arkorobotics/CUBEX_V1/Code/Adafruit_VC0706/README.txt

  This is a library for the Adafruit TTL JPEG Camera (VC0706 chipset)

  Pick one up today in the adafruit shop!
  ------> http://www.adafruit.com/products/397

  These displays use Serial to communicate, 2 pins are required to interface

  Adafruit invests time and resources providing this open source code, 
  please support Adafruit and open-source hardware by purchasing 
  products from Adafruit!

  Written by Limor Fried/Ladyada for Adafruit Industries.  
  BSD license, all text above must be included in any redistribution

To download. click the DOWNLOADS button in the top right corner, rename the uncompressed folder Adafruit_VC0706. Check that the Adafruit_VC0706 folder contains Adafruit_VC0706.cpp and Adafruit_VC0706.h

Place the Adafruit_VC0706 library folder your <arduinosketchfolder>/libraries/ folder. You may need to create the libraries subfolder if its your first library. Restart the IDE.
