arkorobotics/CUBEX_V1/Board/BOM.xlsx

MOTHERBOARD
Part | Value | Device | Package | Description | LINK
C1 | 9pF | CAP0805 | 0805 | Capacitor | http://www.digikey.com/product-detail/en/CL21C090DBANNNC/1276-2559-1-ND/3890645
C2 | 9pF | CAP0805 | 0805 | Capacitor | http://www.digikey.com/product-detail/en/CL21C090DBANNNC/1276-2559-1-ND/3890645
C3 | 0.1uF | CAP0805 | 0805 | Capacitor | http://www.digikey.com/product-detail/en/C0805C104K5RACTU/399-1170-1-ND/411445
C4 | 0.01uF | CAP0805 | 0805 | Capacitor | http://www.digikey.com/product-detail/en/C0805C103K5RACTU/399-1158-1-ND/411433
C5 | 10uF | CAP_POL1206 | EIA3216 | Capacitor Polarized | http://www.digikey.com/product-detail/en/CL31A106KAHNNNE/1276-1075-1-ND/3889161
C6 | 1uF | CAP_POL1206 | EIA3216 | Capacitor Polarized | http://www.digikey.com/product-detail/en/C3216X7R1E105K085AA/445-1592-1-ND/603227
C7 | 0.1uF | SPARKFUN_CAP0805 | SPARKFUN_0805 | Capacitor | http://www.digikey.com/product-detail/en/C0805C104K5RACTU/399-1170-1-ND/411445
J1 | AVR ICSP | SPARKFUN_AVR_SPI_PRG_6NS | SPARKFUN_2X3-NS | AVR ISP 6 Pin | http://www.digikey.com/product-detail/en/961206-6404-AR/3M9459-ND/2071500
JP1 | M102MMSMD | M102MMSMD | 1X10-2MM-SMD | Header 10 | http://www.digikey.com/product-detail/en/0/3M9344DKR-ND
JP2 | M102MMSMD | M102MMSMD | 1X10-2MM-SMD | Header 10 | http://www.digikey.com/product-detail/en/0/3M9388DKR-ND
JP3 | M102MMSMD | M102MMSMD | 1X10-2MM-SMD | Header 10 | http://www.digikey.com/product-detail/en/0/3M9344DKR-ND
JP4 | M102MMSMD | M102MMSMD | 1X10-2MM-SMD | Header 10 | http://www.digikey.com/product-detail/en/0/3M9388DKR-ND
Q1 | SPARKFUN_MOSFET-PCHANNELSMD | SPARKFUN_MOSFET-PCHANNELSMD | SPARKFUN_SOT23-3 |  | http://www.digikey.com/product-detail/en/BSS84/BSS84CT-ND/244297
R1 | 10k | RESISTOR0805-RES | 0805 | Resistor | http://www.digikey.com/product-detail/en/RC0805JR-0710KL/311-10KARCT-ND/731188
R4 | 100R | SPARKFUN_RESISTOR0805-RES | 0805 | Resistor | http://www.digikey.com/product-detail/en/RC0805FR-07100RL/311-100CRCT-ND/730490
R5 | 10k | SPARKFUN_RESISTOR0805-RES | 0805 | Resistor | http://www.digikey.com/product-detail/en/RC0805JR-0710KL/311-10KARCT-ND/731188
U$2 | AVA_EDGE_ICSP | AVA_EDGE_ICSP | AVA_EDGE_MOUNTED_ICSP |  | http://www.digikey.com/product-detail/en/961206-6404-AR/3M9459-ND/2071500
U$3 | AVA_JTI_ANTENNA-1575AT43A40 | AVA_JTI_ANTENNA-1575AT43A40 | AVA_JTI_ANTENNA-1575AT43A40 |  | http://ava.upuaut.net/store/index.php?route=product/product&path=59_65&product_id=55
U$4 | AVA_UBLOX_MAX-6 | AVA_UBLOX_MAX-6 | AVA_UBLOX_MAX-6 | UBLOX MAX-6 | http://ava.upuaut.net/store/index.php?route=product/product&path=59_64&product_id=81
U$5 | AVA_EPSON_FA-20H_CRYSTAL | AVA_EPSON_FA-20H_CRYSTAL | AVA_EPSON-FA-20H-CRYSTAL |  | http://www.digikey.com/product-detail/en/CX3225SB16000E0FPZ25/478-4815-1-ND/1833878
U1 | AVA_ATMEGA328P-MU | AVA_ATMEGA328P-MU | AVA_QFN50P500X500X100-33N | Programmable Flash | http://www.digikey.com/product-detail/en/ATMEGA328P-MUR/ATMEGA328P-MURCT-ND/3440953
POWER BOARD
Part | Value | Device | Package | Description | LINK
C1 | 47pF | CAP1206 | 1206 | Capacitor | http://www.digikey.com/product-detail/en/C1206C470J5GACTU/399-1201-1-ND/411476
C2 | 220pF | CAP1206 | 1206 | Capacitor | http://www.digikey.com/product-detail/en/CL31C221JCCNNNC/1276-2821-1-ND/3890907
C3 | 22uF | CAP1206 | 1206 | Capacitor | http://www.digikey.com/product-detail/en/LMK316F226ZL-T/587-1356-1-ND/931133
C4 | 10uF | CAP1206 | 1206 | Capacitor | http://www.digikey.com/product-detail/en/CL31A106KAHNNNE/1276-1075-1-ND/3889161
C5 | 1.0uF | CAP0805 | 0805 | Capacitor | http://www.digikey.com/product-detail/en/CL21B105KBFNNNE/1276-1029-1-ND/3889115
C7 | 4.7uF | CAP0805 | 0805 | Capacitor | http://www.digikey.com/product-detail/en/CL21A475KOFNNNE/1276-1065-1-ND/3889151
C9 | 10uF | CAP1206 | 1206 | Capacitor | http://www.digikey.com/product-detail/en/CL31A106KAHNNNE/1276-1075-1-ND/3889161
C10 | 10uF | CAP1206 | 1206 | Capacitor | http://www.digikey.com/product-detail/en/CL31A106KAHNNNE/1276-1075-1-ND/3889161
JP1 | M102MMSMD | M102MMSMD | 1X10-2MM-SMD | Header 10 | http://www.digikey.com/product-detail/en/0/3M9344DKR-ND
JP2 | M102MMSMD | M102MMSMD | 1X10-2MM-SMD | Header 10 | http://www.digikey.com/product-detail/en/0/3M9388DKR-ND
JP3 | M102MMSMD | M102MMSMD | 1X10-2MM-SMD | Header 10 | http://www.digikey.com/product-detail/en/0/3M9344DKR-ND
JP4 | M102MMSMD | M102MMSMD | 1X10-2MM-SMD | Header 10 | http://www.digikey.com/product-detail/en/0/3M9388DKR-ND
JP7 | JST-2-PTH | M02JST-PTH-2 | JST-2-PTH | Header 2 | http://www.digikey.com/product-detail/en/S2B-PH-K-S(LF)(SN)/455-1719-ND/926626
R1 | 49.9k | RESISTOR1206 | 1206 | Resistor | http://www.digikey.com/product-detail/en/RC1206FR-0749K9L/311-49.9KFRCT-ND/731890
R2 | 221k | RESISTOR1206 | 1206 | Resistor | http://www.digikey.com/product-detail/en/CR1206-FX-2213ELF/CR1206-FX-2213ELFCT-ND/3767664
R3 | 1M | RESISTOR1206 | 1206 | Resistor | http://www.digikey.com/product-detail/en/ERJ-8ENF1004V/P1.00MFCT-ND/90014
R4 | 6.49k | RESISTOR1206 | 1206 | Resistor | http://www.digikey.com/product-detail/en/RC1206FR-076K49L/311-6.49KFRCT-ND/731969
R5 | 40.2k | RESISTOR0805-RES | 0805 | Resistor | http://www.digikey.com/product-detail/en/RC0805FR-0740K2L/311-40.2KCRCT-ND/730888
R6 | 1020k | RESISTOR0805-RES | 0805 | Resistor | http://www.digikey.com/product-detail/en/RC0805FR-071M02L/311-1.02MCRCT-ND/730395
R7 | 332k | RESISTOR0805-RES | 0805 | Resistor | http://www.digikey.com/product-detail/en/RC0805FR-07332KL/311-332KCRCT-ND/730816
R8 | 20k | RESISTOR0805-RES | 0805 | Resistor | http://www.digikey.com/product-detail/en/ERJ-6ENF2002V/P20.0KCCT-ND/119348
R9 | DNP | RESISTOR0805-RES | 0805 | Resistor | -
U$1 | LTC3105 | LTC3105 | LTC3105 |  | http://www.digikey.com/product-detail/en/LTC3105EMS%23PBF/LTC3105EMS%23PBF-ND/2601181
U$2 | 4.7uH | STEVESCOILCRAFT_COILCRAFT_LPS4018 | STEVESCOILCRAFT_COILCRAFT_LPS4018 | CoilCraft LPS4018 series inductor | http://www.newark.com/coiltronics/sd53-4r7-r/inductor-shielded-4-7uh-2-1a-smd/dp/99M5532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
U$3 | LTC3536 | LTC3536 | LTC3536-MSE |  | http://www.digikey.com/product-detail/en/LTC3536EMSE%23PBF/LTC3536EMSE%23PBF-ND/2720693
U$4 | 10uH | STEVESCOILCRAFT_COILCRAFT_LPS4018 | STEVESCOILCRAFT_COILCRAFT_LPS4018 | CoilCraft LPS4018 series inductor | http://www.newark.com/coiltronics/sd53-100-r/inductor-shielded-10uh-1-4a-smd/dp/99M5527
U$5 | LTC4071 | LTC4071 | LTC4071 |  | http://www.newark.com/linear-technology/ltc4071ems8e-pbf/ic-batt-chrg-li-ion-li-polymer/dp/13T8411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
U1 | EM408_CON | EM408_CON | EM408_CON |  | http://www.digikey.com/product-detail/en/SM05B-SRSS-TB(LF)(SN)/455-1805-1-ND/926876
RADIO BOARD
Part | Value | Device | Package | Description | LINK
C0 | 15.0pF | CAP0805 | 0805 | Capacitor | http://www.digikey.com/product-detail/en/CC0805JRNPO9BN150/311-1101-1-ND/303011
C1 | 10nF | CAP0805 | 0805 | Capacitor | http://www.digikey.com/product-detail/en/C0805C103K5RACTU/399-1158-1-ND/411433
C2 | 0.1uF | CAP0805 | 0805 | Capacitor | http://www.digikey.com/product-detail/en/C0805C104K5RACTU/399-1170-1-ND/411445
C3 | 1uF | CAP0805 | 0805 | Capacitor | http://www.digikey.com/product-detail/en/CL21B105KBFNNNE/1276-1029-1-ND/3889115
C4 | 15.0pF | CAP0805 | 0805 | Capacitor | http://www.digikey.com/product-detail/en/CC0805JRNPO9BN150/311-1101-1-ND/303011
CM | 8.2pF | CAP0805 | 0805 | Capacitor | http://www.digikey.com/product-detail/en/C0805C829D5GACTU/399-8121-1-ND/3471844
CM2 | 15.0pF | CAP0805 | 0805 | Capacitor | http://www.digikey.com/product-detail/en/CC0805JRNPO9BN150/311-1101-1-ND/303011
CM3 | 6.8pF | CAP0805 | 0805 | Capacitor | http://www.digikey.com/product-detail/en/C0805C689D5GACTU/399-9270-1-ND/3522788
CR1 | 3.9pF | CAP0805 | 0805 | Capacitor | http://www.digikey.com/product-detail/en/C0805C399C5GACTU/399-8078-1-ND/3471801
CR2 | 2.2pF | CAP0805 | 0805 | Capacitor | http://www.digikey.com/product-detail/en/C0805C229D5GACTU/399-9211-1-ND/3522729
J$1 | SMA_EDGE | SMA_EDGE | SMA-EDGE | SMA Antenna Connector | http://www.digikey.com/product-detail/en/EMPCB.SMAFSTJ.B.HT/931-1175-ND/3522337
JP1 | M102MMSMD | M102MMSMD | 1X10-2MM-SMD | Header 10 | http://www.digikey.com/product-detail/en/0/3M9344DKR-ND
JP2 | M102MMSMD | M102MMSMD | 1X10-2MM-SMD | Header 10 | http://www.digikey.com/product-detail/en/0/3M9388DKR-ND
JP3 | M102MMSMD | M102MMSMD | 1X10-2MM-SMD | Header 10 | http://www.digikey.com/product-detail/en/0/3M9344DKR-ND
JP4 | M102MMSMD | M102MMSMD | 1X10-2MM-SMD | Header 10 | http://www.digikey.com/product-detail/en/0/3M9388DKR-ND
L0 | 39nH | INDUCTOR0805 | 0805 | Inductors | http://www.digikey.com/product-detail/en/AIMC-0805-39NJ-T/535-11565-1-ND/2782806
LCHOKE | 220nH | INDUCTOR0805 | 0805 | Inductors | http://www.digikey.com/product-detail/en/MLF2012DR22KT000/445-1039-1-ND/504437
LM | 18nH | INDUCTOR0805 | 0805 | Inductors | http://www.digikey.com/product-detail/en/AIMC-0805-18NJ-T/535-11557-1-ND/2782802
LM2 | 18nH | INDUCTOR0805 | 0805 | Inductors | http://www.digikey.com/product-detail/en/AIMC-0805-18NJ-T/535-11557-1-ND/2782802
LR1 | 56nH | INDUCTOR0805 | 0805 | Inductors | http://www.digikey.com/product-detail/en/AIMC-0805-56NJ-T/535-11570-1-ND/2782808
LR2 | 51nH | INDUCTOR0805 | 0805 | Inductors | http://www.digikey.com/product-detail/en/MLF2012D47NMT000/445-1032-1-ND/504430
R1 | 100k | RESISTOR0805-RES | 0805 | Resistor | http://www.digikey.com/product-detail/en/RC0805FR-07100KL/311-100KCRCT-ND/730491
R2 | 100k | RESISTOR0805-RES | 0805 | Resistor | http://www.digikey.com/product-detail/en/RC0805FR-07100KL/311-100KCRCT-ND/730491
U$1 | SI4464 | SI4464 | QFN20+GNDPAD |  | http://www.digikey.com/product-detail/en/SI4464-B1B-FM/336-2472-5-ND/3681120
U$2 | CRYSTAL_3.2X2.5-TCXO | CRYSTAL_3.2X2.5-TCXO | CRYSTAL_3.2X2.5-TCXO |  | http://www.newark.com/txc/7l-26-000mbg-t/oscillator-tcxo-26mhz-smd/dp/82T5820
 |  | Connectors |  |  | http://www.newark.com/webapp/wcs/stores/servlet/ProductDisplay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
 |  | Connectors |  |  | http://www.newark.com/webapp/wcs/stores/servlet/ProductDisplay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
