arkorobotics/CUBEX_V1/(threads)

Thread 4 (2015-11-02):

I can't find the schematic

Oatmas64134, 2015-11-02:
Could I please have some help with finding the schematic?

willrea, 2015-11-03:
The schematic files for Eagle are here: https://github.com/arkorobotics/CUBEX_V1/tree/master/Board

They're the *.sch files

Oatmas64134, 2015-11-03:
How do I use them? I am using chromeOS

willrea, 2015-11-04:
Used need to download and install Eagle CAD, but it'll only run on Windows/OS X/Linux. If you're just wanting to look at the schematics I can generate images of them for you.

Oatmas64134, 2015-11-04:
Oh no, that won`t be necessary. I just needed to know how to view them.

Oatmas64134, 2015-11-04:
Also, where do i download Eagle CAD?

willrea, 2015-11-05:
www.cadsoftusa.com/download-eagle/
