arkorobotics/CUBEX_V1/Board/cubex_motherboard.brd

## EAGLE design Board/cubex_motherboard.brd (2014-06-24)

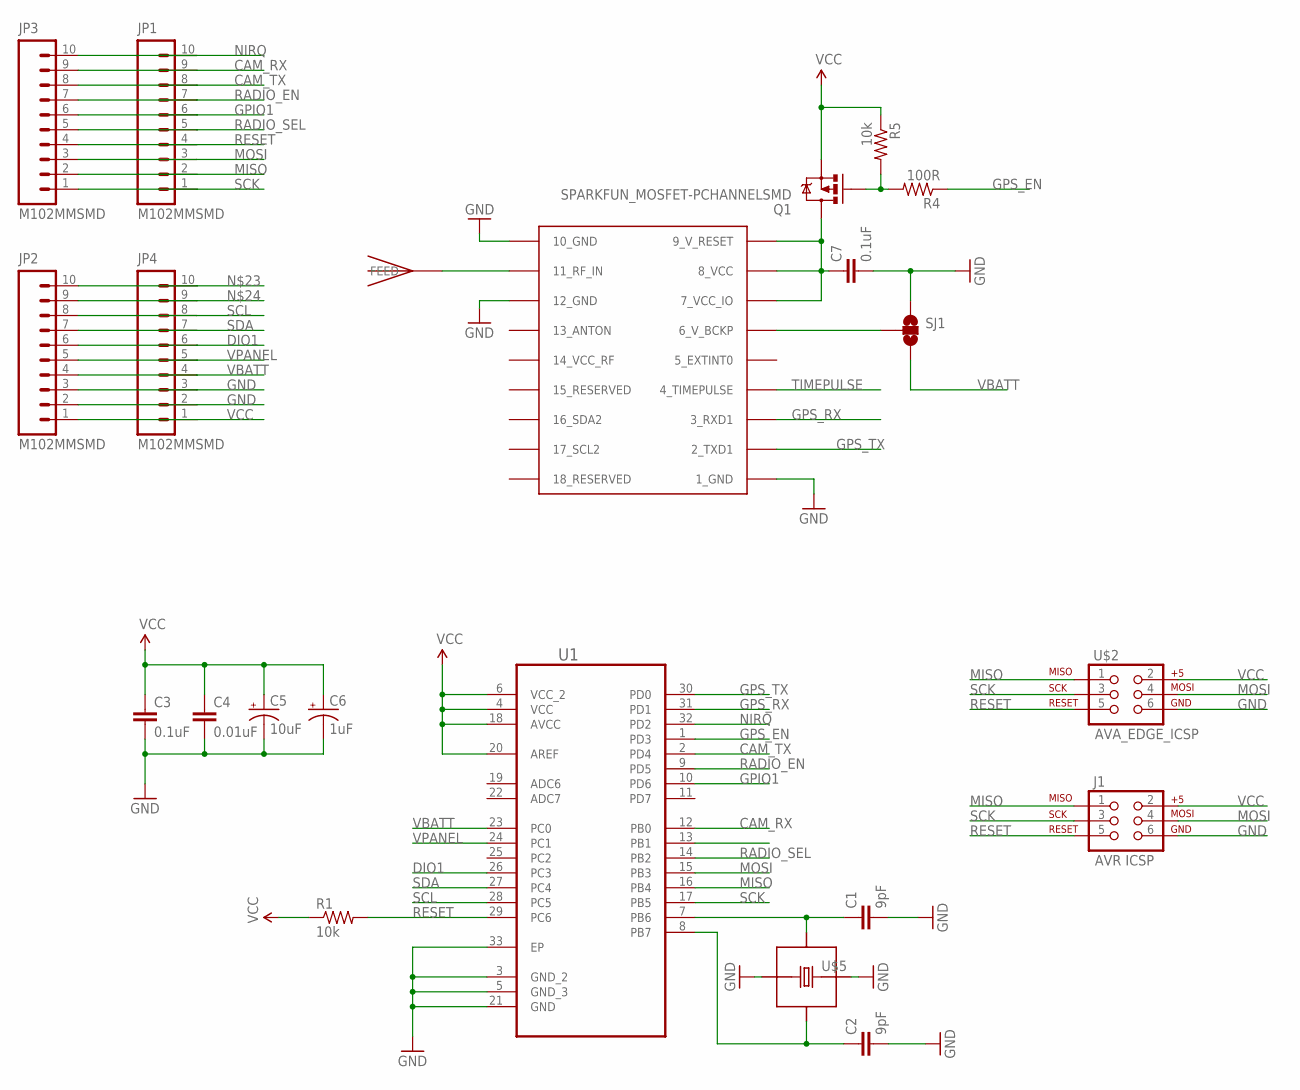
[picture p1: schematic cubex_motherboard.sch]

Parts:
C1, C2: 9pF; 0805
C3: 0.1uF; 0805
C4: 0.01uF; 0805
C5: 10uF; EIA3216
C6: 1uF; EIA3216
C7: 0.1uF; SPARKFUN_0805
J1: AVR ICSP; SPARKFUN_2X3-NS
JP1, JP2, JP3, JP4: M102MMSMD; 1X10-2MM-SMD
Q1: SPARKFUN_MOSFET-PCHANNELSMD; SPARKFUN_SOT23-3
R1: 10k; 0805
R4: 100R; SPARKFUN_0805
R5: 10k; SPARKFUN_0805
SJ1: SPARKFUN_SOLDERJUMPER_2WAYT; SPARKFUN_SJ_2
U1: AVA_ATMEGA328P-MU; AVA_QFN50P500X500X100-33N
U$2: AVA_EDGE_ICSP; AVA_EDGE_MOUNTED_ICSP
U$3: AVA_JTI_ANTENNA-1575AT43A40
U$4: AVA_UBLOX_MAX-6
U$5: AVA_EPSON_FA-20H_CRYSTAL; AVA_EPSON-FA-20H-CRYSTAL

Connections:
CAM_RX: JP1.9, JP3.9, U1.12 (PB0)
CAM_TX: JP1.8, JP3.8, U1.2 (PD4)
DIO1: JP2.6, JP4.6, U1.26 (PC3)
GND: C1.2, C2.2, C3.2, C4.2, C5.C (-), C6.C (-), C7.2, J1.6, JP2.2, JP2.3, JP4.2, JP4.3, SJ1.1, U1.3 (GND_2), U1.5 (GND_3), U1.21 (GND), U1.33 (EP), U$2.6, U$4.1_GND, U$4.10_GND, U$4.12_GND, U$5.1, U$5.3
GPIO1: JP1.6, JP3.6, U1.10 (PD6)
GPS_EN: R4.1, U1.1 (PD3)
GPS_RX: U1.31 (PD1), U$4.3_RXD1
GPS_TX: U1.30 (PD0), U$4.2_TXD1
MISO: J1.1, JP1.2, JP3.2, U1.16 (PB4), U$2.1
MOSI: J1.4, JP1.3, JP3.3, U1.15 (PB3), U$2.4
unnamed: C7.1, Q1.3 (D), U$4.7_VCC_IO, U$4.8_VCC, U$4.9_V_RESET
unnamed: SJ1.2, U$4.6_V_BCKP
unnamed: Q1.1 (G), R4.2, R5.2
unnamed: U$3.FEED, U$4.11_RF_IN
unnamed: C1.1, U1.7 (PB6), U$5.4
unnamed: C2.1, U1.8 (PB7), U$5.2
unnamed: JP2.10, JP4.10
unnamed: JP2.9, JP4.9
NIRQ: JP1.10, JP3.10, U1.32 (PD2)
RADIO_EN: JP1.7, JP3.7, U1.9 (PD5)
RADIO_SEL: JP1.5, JP3.5, U1.14 (PB2)
RESET: J1.5, JP1.4, JP3.4, R1.2, U1.29 (PC6), U$2.5
SCK: J1.3, JP1.1, JP3.1, U1.17 (PB5), U$2.3
SCL: JP2.8, JP4.8, U1.28 (PC5)
SDA: JP2.7, JP4.7, U1.27 (PC4)
TIMEPULSE: U$4.4_TIMEPULSE
VBATT: JP2.4, JP4.4, SJ1.3, U1.23 (PC0)
VCC: C3.1, C4.1, C5.A (+), C6.A (+), J1.2, JP2.1, JP4.1, Q1.2 (S), R1.1, R5.1, U1.4 (VCC), U1.6 (VCC_2), U1.18 (AVCC), U1.20 (AREF), U$2.2
VPANEL: JP2.5, JP4.5, U1.24 (PC1)

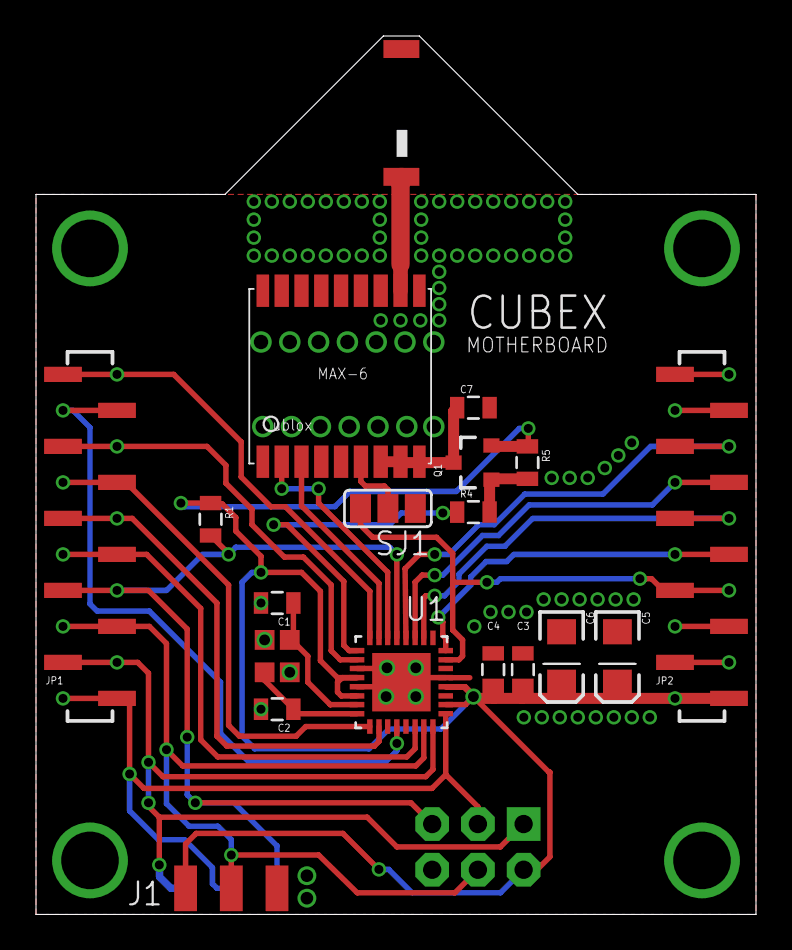
[picture p2: board cubex_motherboard.brd from above]

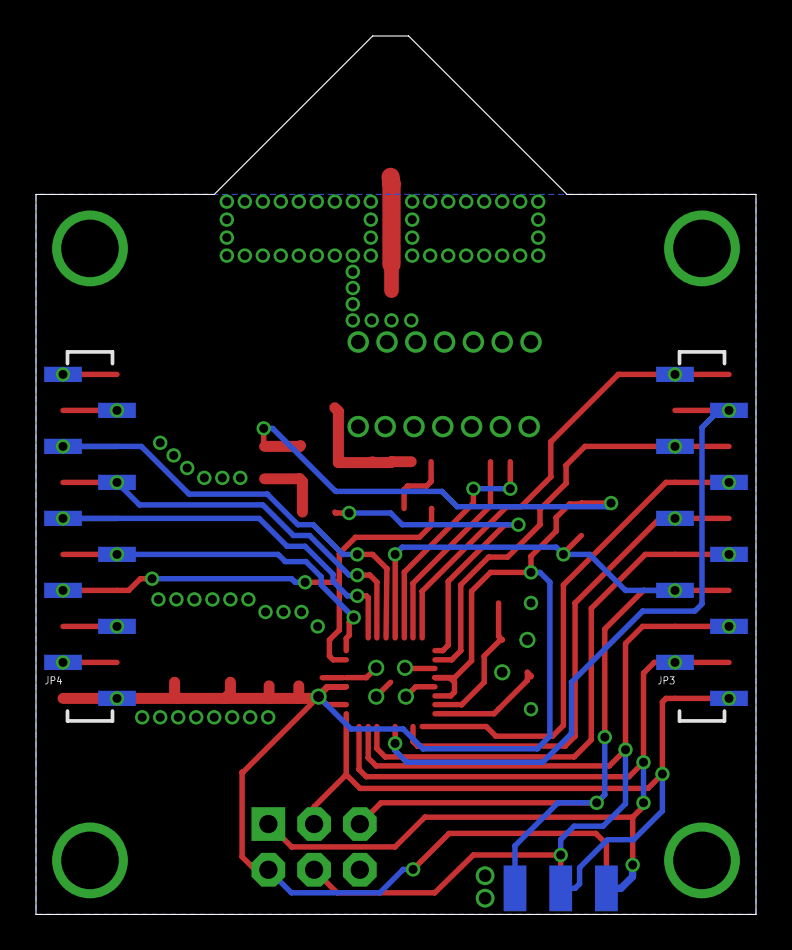
[picture p3: board cubex_motherboard.brd from below]

Board: 2 copper layers, 40.0 x 48.8 mm, 22 parts (2 on the bottom side), 28 nets.
