arkorobotics/CUBEX_V1/Board/cubex_camera.brd

## EAGLE design Board/cubex_camera.brd (2014-06-24)

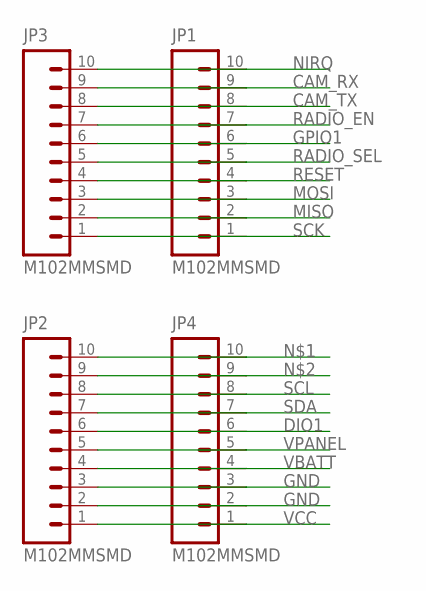
[picture p4: schematic cubex_camera.sch]

Parts:
JP1, JP2, JP3, JP4: M102MMSMD; 1X10-2MM-SMD

Connections:
CAM_RX: JP1.9, JP3.9
CAM_TX: JP1.8, JP3.8
DIO1: JP2.6, JP4.6
GND: JP2.2, JP2.3, JP4.2, JP4.3
GPIO1: JP1.6, JP3.6
MISO: JP1.2, JP3.2
MOSI: JP1.3, JP3.3
unnamed: JP2.10, JP4.10
unnamed: JP2.9, JP4.9
NIRQ: JP1.10, JP3.10
RADIO_EN: JP1.7, JP3.7
RADIO_SEL: JP1.5, JP3.5
RESET: JP1.4, JP3.4
SCK: JP1.1, JP3.1
SCL: JP2.8, JP4.8
SDA: JP2.7, JP4.7
VBATT: JP2.4, JP4.4
VCC: JP2.1, JP4.1
VPANEL: JP2.5, JP4.5

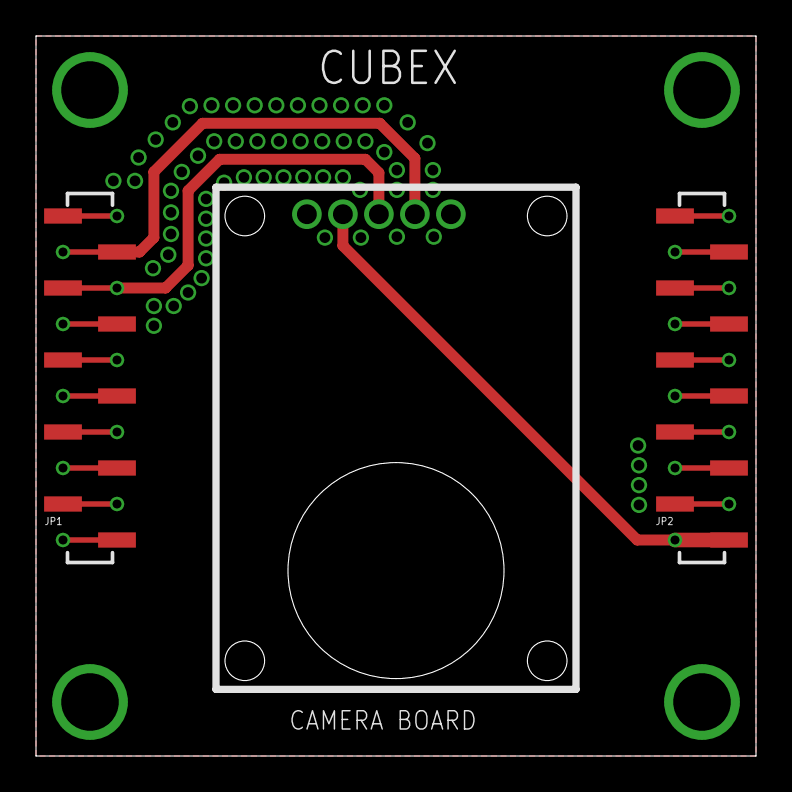
[picture p5: board cubex_camera.brd from above]

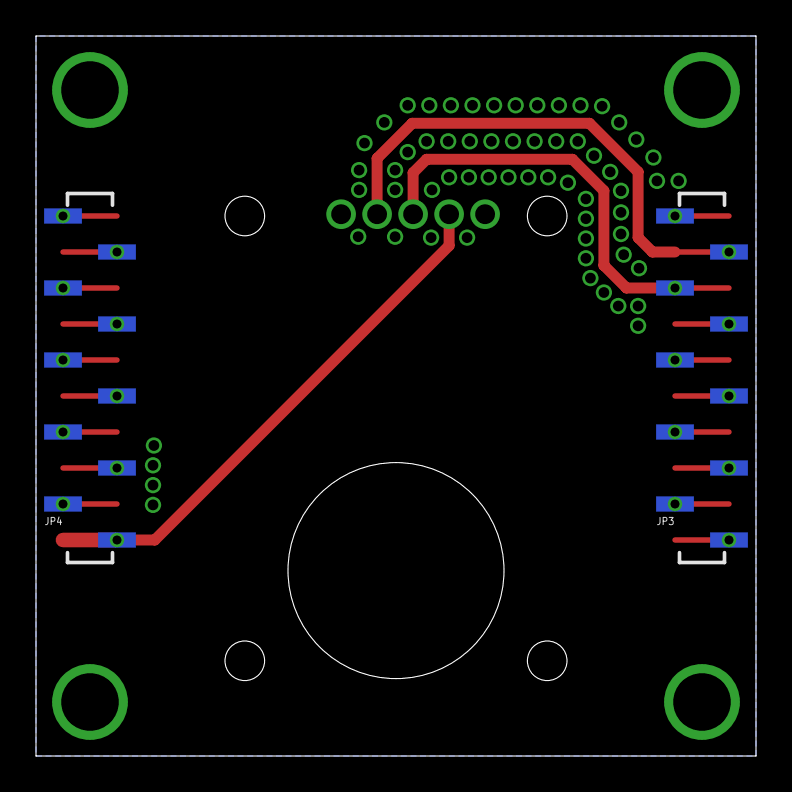
[picture p6: board cubex_camera.brd from below]

Board: 2 copper layers, 40.0 x 40.0 mm, 4 parts (2 on the bottom side), 19 nets.
