arkorobotics/CUBEX_V1/(commit log)

2014-04-28 Added Adafruit VC0706 library
    Place this in the arduino libraries (THIS IS LIBRARY HAS BEEN MODIFIED)
2014-05-01 Sending data, bad jpeg
    possible pointer problem
    [CUBEX_V1.ino, config.h]
2014-06-12 Fixed ssdv crash when camera doesnt respond
    - Fixed ssdv crash when camera doesnt respond
    - change frequency
    [CUBEX_V1.ino, config.h]
2014-06-24 Added board/BOM
    Added board/BOM
    [BOM.xlsx, cubex_camera.brd, cubex_camera.sch, cubex_motherboard.brd, cubex_motherboard.sch, cubex_power.brd, cubex_power.sch, cubex_radio.brd]
